DigrandeArduino/ArduinoAeroglisseur/rapportFinSeances/digrandeThomas/rapportSeance09-12-19.md

Tâche réalisé par Thomas Di Grande
Rapport Seance 01

Travail maison avant séance : Réalisation des plans 3d de la structure de la jupe; Réalisation du planning et de la répartition des tâches première séances; Commande matérielle (moteurs, contrôleurs, câbleries).

Voici l'ensemble des tâches réalisé durant cette première séance : téléchargement d'un logiciel de création du fichier SVG; Preparation du plan 3d des deux pièces de la jupe pour la découpe laser; Pour ce faire, utilisation du logiciel Inkscape. But : créé une image vectorielle du plan 2D; Plan vectoriel au format SVG; Envoie de ce fichier au FabLab pour découpe laser des deux pièces.

Final : rendez vous avec le FabLab pour realisé la decoupe laser des deux pieces.

Suite de la séance : Test des moteurs brushless avec un code d'essai (voir dossier code; fichier testbrushless.md). Résultat : puissance motrice suffisante pour générer un flux d'air important. Flux d'air suffisant (?) : à confirmer. Suite : Trouver deux hélices de tailles  120 mm. Commande des hélices.

Matériel obtenue à ce jour : 6 controleurs brushless; moteurs brushless; Cablerie; Alimentation de test.
                             
Modification de la structure sur le plan 3D pour fixer les moteurs surs la chassie de la jupe.
Mail envoyé au FabLab.

Fin de rapport;
