DigrandeArduino/ArduinoAeroglisseur/cahierDesCharge.md

Cahier des charge du projet arduino :
|------------------------------------------------------------------------------------------
| Informations générales :
|------------------------------------------------------------------------------------------
| Noms : Arduino Aerogliseur; ArduinoGlisseur;
| Entreprise : Aero Tech Industrie;
| Type : Véhicule terrestre;
| Nom responsable projet : P. Masson;
| Noms participants projet : Thomas Di Grande -- Julien Whitfield;
|------------------------------------------------------------------------------------------
| Contraintes : (A -> Prioritaire; B -> option)
|------------------------------------------------------------------------------------------
| A-1 : Le prototype doit pouvoir se soulever au-dessus du sol;
| A-2 : Le prototype doit être autonome en energie pour une durer supèrieurs à 10 minutes;
| A-3 : Le prototype doit avoir une solidité suffisante pour résister à des chocs légers voire modérer;
| A-4 : Le prototype doit être stable peut importe la surface;
| A-5 : Le prototype doit être soulevé au dessus du sol par deux moteurs type brushless;
| A-6 : Le prototype doit être auto propulsé par deux moteurs arrières;
| A-7 : Le prototype doit resté stable lors de ses déplacements;
| A-8 : Le prototype doit être radio guidé par l'utilisateur; 
| -8- : La conception inclut la réalisation de la télécommande RF;
| A-9 : Le prototype doit être facilement réparable; 
| -9- : Accès simplifié au câble et cartes électroniques;
|------------------------------------------------------------------------------------------
| B-1 : Le prototype doit pouvoir renvoyer une vidéo en direct à l'utilisateur;
| -1- : Retour video sur ordinateur ou smartphone par liaison WIFI;
| B-2 : Le prototype doit être esthétique;
| -2- : Ajout d'une maquette de cabine + autocollant + peinture;
| B-3 : Le prototype doit détecter les obstacles, gestion arrêt d'urgence;
| B-4 : Le prototype doit être équipé d'un canon antiaérien;
| -4- : En réponse à un projet concurrent, dans l’éventualité qu'il fonctionne (le projet concurrent);
| B-5 : Detaillage de la décoration si temps disponible;
|------------------------------------------------------------------------------------------
| Contrainte suplémentaire : Le prototype ne doit pas exploser ou s'enflammer spontanément.
|------------------------------------------------------------------------------------------
