DigrandeArduino/ArduinoAeroglisseur/rapportFinSeances/digrandeThomas/rapportSeance19.02.2020.pdf

## Rapport Séance n°7 20.02.2020

Thomas Di Grande Peip 2 G1

Travaux réalisés avant la séance :

- Démontage total de toute l’électroniques
- Test de chaque moteur séparer sur banc d’essai.
- Test de chaque contrôleur séparer sur banc d’essai.
- Démontage de la structure central de support des cartes électroniques.

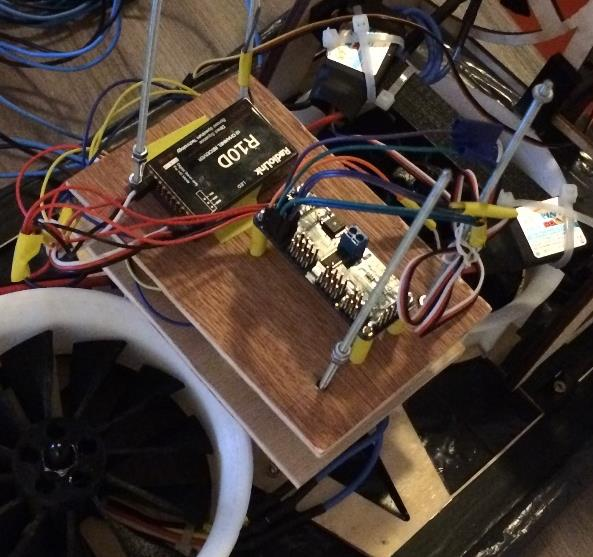
[picture p17: figure]

<- Cette pièce là

- Bilan des tests :
➔ Tous les moteurs fonctionnent.
➔ Tous les contrôleurs fonctionnent.
➔ L’ensemble carte + générateur PWM fonctionne.

Les dégâts causés par la coupure de courant à la suite d’un court-circuit dans l’alimentation sont mineur et n’ont engendré aucun dommage sur le matériel.

- Remontage de toutes l’électronique : soudage de tous les câbles avec sécurisation des soudures par gaine thermo-rétractable.
- Bilan de la reconstruction : 6h de travail samedi mais le prototype fonctionne
- Problème constater : erreur au niveau du code, sera corriger durant la séance.

Travaux réalisés durant la séance :

- Correction des erreurs dans le code :
➔ Calibrage des hélices
➔ Synchronisation entre les paliers de démarrage des moteurs et les joysticks de la télécommande.
- Récupération du matériel demander : sac renforcer plastique pour la nouvelle jupe de l’aéroglisseur.
- Etat du prototype après réparation :

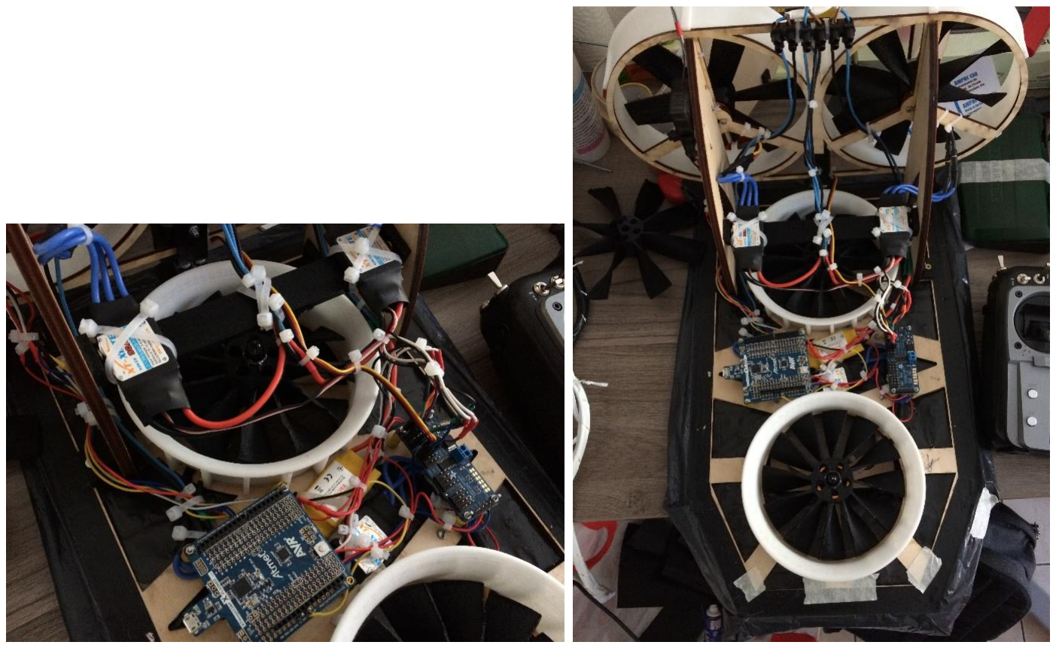
[picture p18: figure]

- Premier test de déplacement :
➔ Le prototype fonctionne, est capable de se soulever, d’avancer et de tourner.
➔ Problème constater : difficulté à tourner, pourras être partiellement corriger par le changement des hélices de propulsion.
➔ Autre problème : obligation de placer une roue folle à l’arrière du prototype. Pourras être corriger en améliorant les hélices de sustentation et en réajustant le poids à l’arrière.
- Bilan globale :
Premiers tests de déplacement concluent. Le prototype fonctionne correctement, est suffisamment solide pour résister à des chocs légers contre les murs (non le pilote n’est pas incompétent bien au contraire, c’est le prototype qui est légèrement incontrôlable…).

- Les changements de direction sont globalement faisables.
- Les objectifs suivants sont surtout de réoptimiser et de stabiliser le prototype.

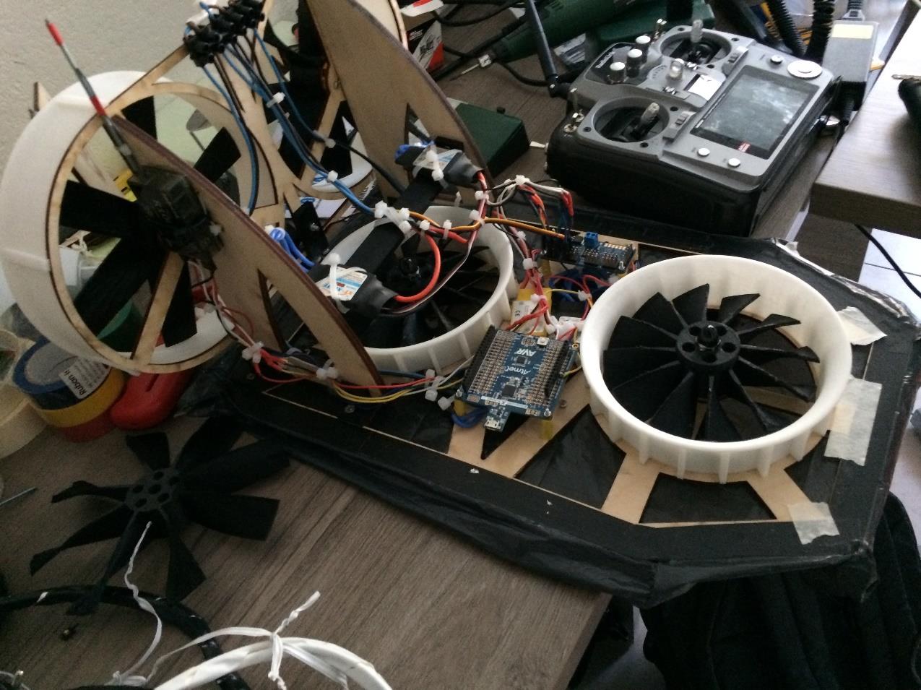
[picture p19: figure]

Fin de rapport ;
