DigrandeArduino/ArduinoAeroglisseur/rapportFinSeances/whitfieldJulien/rapportSeance06-02-2020.pdf

Taches effectuées par WHITFIELD Julien Rapport séance 05

- Compréhension du générateurPWM
- Intégration de la parties PWM au code et au branchement
- Réglage de la puissance des moteurs
- Test de tous les moteurs en même temps
- Programmation d’un bouton on/off
- Fin du code pour la télécommande
