DigrandeArduino/ArduinoAeroglisseur/rapportFinSeances/whitfieldJulien/rapportSeance13-01-2020.pdf

Taches effectuées par WHITFIELD Julien Rapport séance 04

Travaille effectuée :

- Fin du code pour la télécommande
- tests du code sur tous les moteurs, réussite
- test de la télécommande sur les moteurs sur l’aéroglisseur
- obtention d’un générateur PWM pour pouvoir contrôler tous moteurs en même temps

Suite de la séance :

- Apprendre a utiliser et brancher le générateur PWM
- Test de tout moteurs en même temps

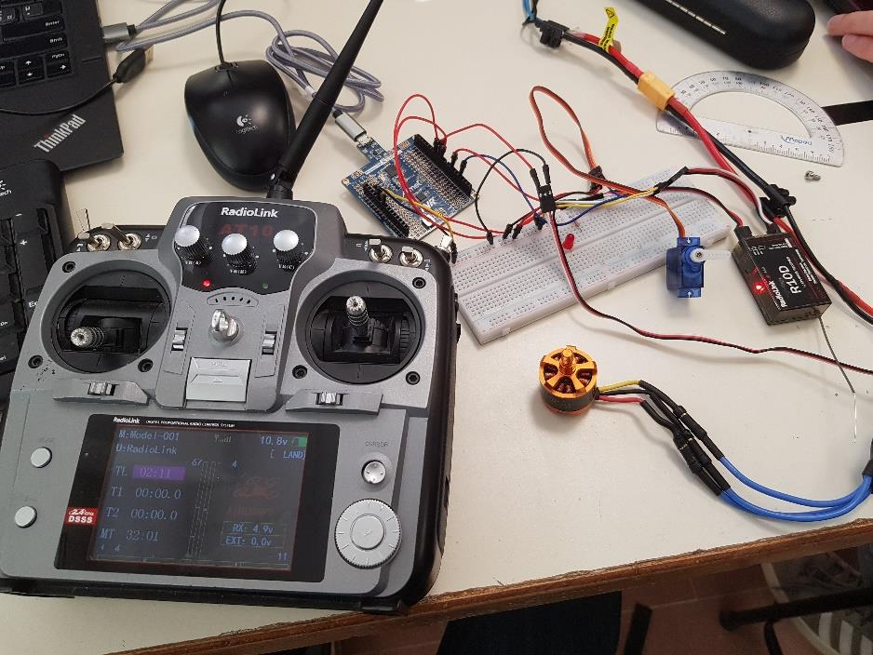
[picture p35: figure]

Télécommande avec moteur brushless et servomoteur connecte a la carte Arduino

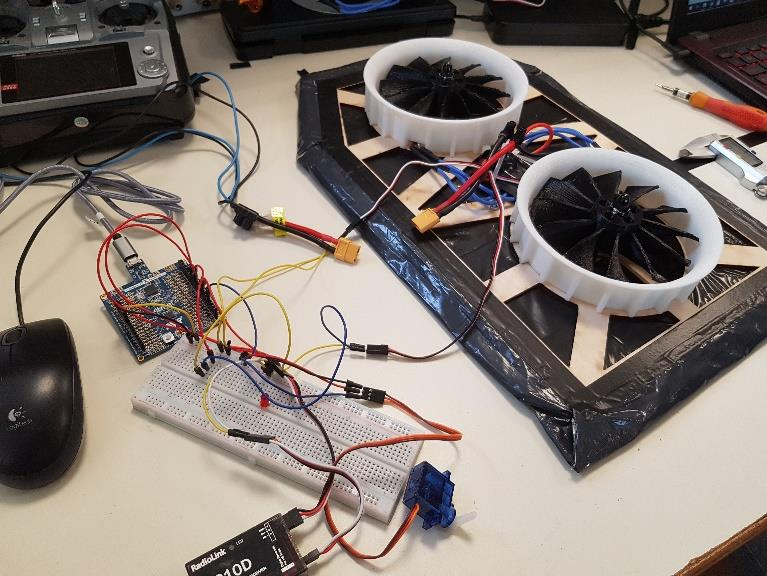
[picture p36: figure]

Moteurs brushless de l’aéroglisseur connecte a la télécommande
