DigrandeArduino/ArduinoAeroglisseur/rapportFinSeances/digrandeThomas/rapportSeance16-12-19.md.pdf

## Rapport Séance n°2 16.12.2019

Thomas Di Grande Peip 2 G 1

Travaux réalisés avant la séance :

- Finalisation de la modélisation 3D de la structure de la jupe.
- Création du modèle de découpe 2D laser. Type de fichier en .svg destiné pour la découpeuse CNC laser.
- Vendredi 13.12.2019 : réalisation de la découpe laser au FabLab de l’école :

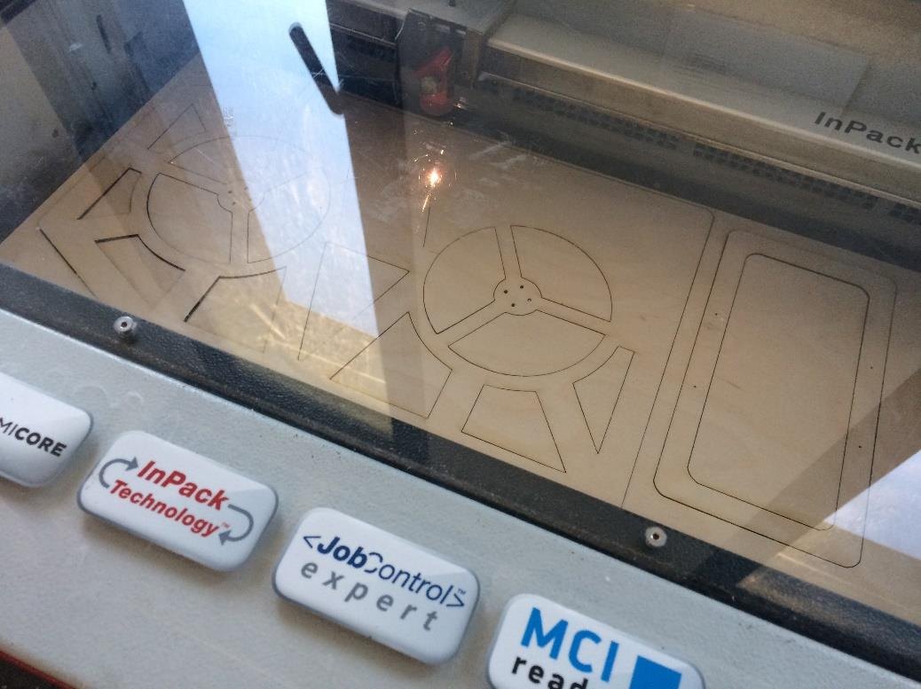
[picture p44: figure]

- Résultat final satisfaisant après découpe :

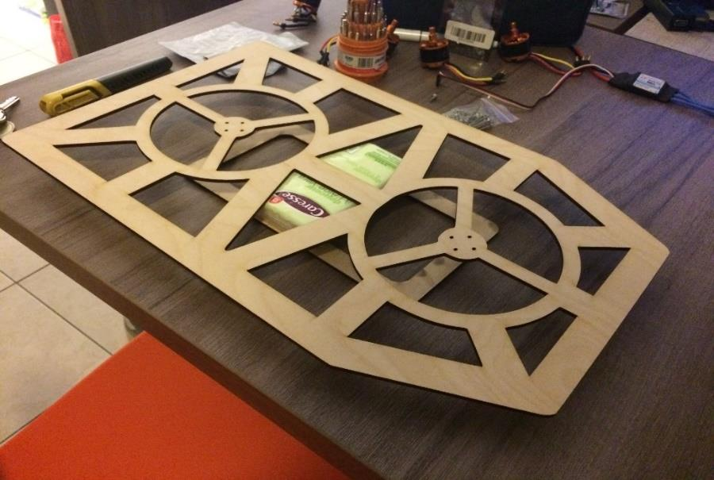
[picture p45: figure]

- Vidéo de la découpe laser : https://www.youtube.com/watch?v=YqbRCXbXSbshttps://www.youtube.com/watch?v=GnK8k1fjNbw

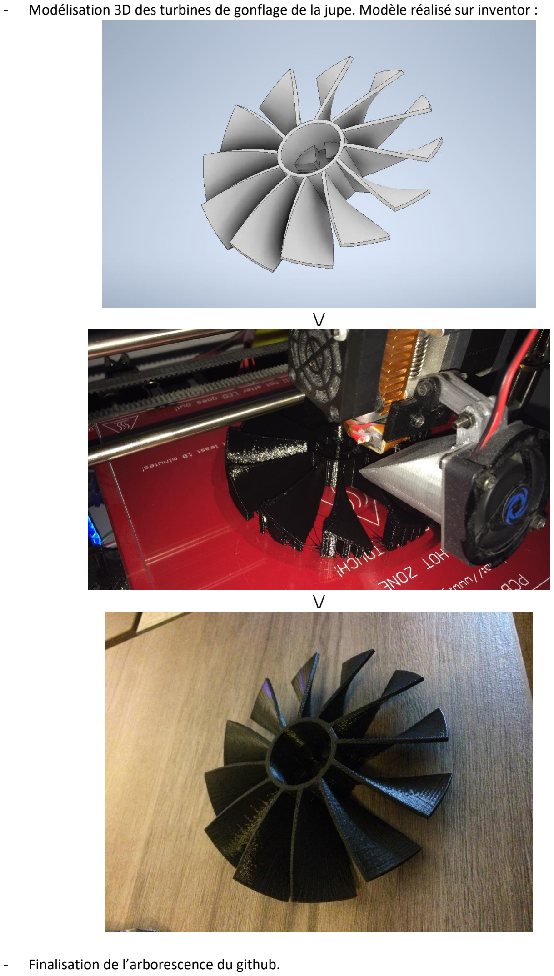
[picture p46: page 2]

- Modélisation 3D des turbines de gonflage de la jupe. Modèle réalisé sur inventor :

\/

\/

- Finalisation de l’arborescence du github.

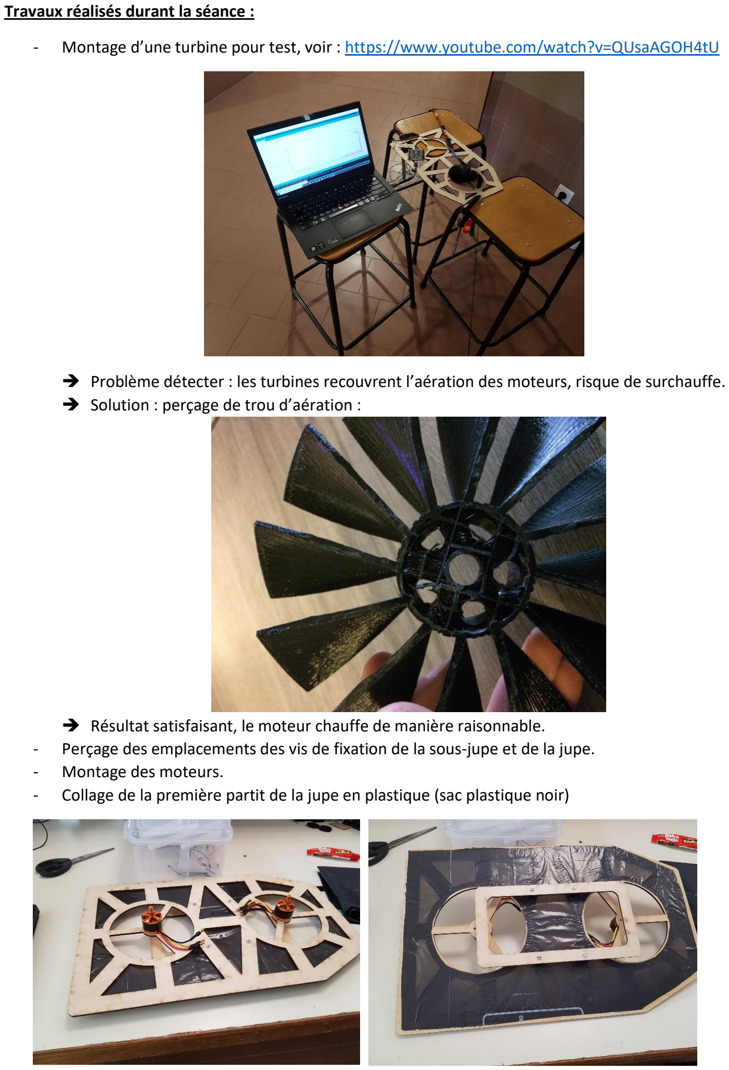
[picture p47: page 3]

Travaux réalisés durant la séance :

- Montage d’une turbine pour test, voir : https://www.youtube.com/watch?v=QUsaAGOH4tU

➔ Problème détecter : les turbines recouvrent l’aération des moteurs, risque de surchauffe. ➔ Solution : perçage de trou d’aération :

➔ Résultat satisfaisant, le moteur chauffe de manière raisonnable.
- Perçage des emplacements des vis de fixation de la sous-jupe et de la jupe.
- Montage des moteurs.
- Collage de la première partit de la jupe en plastique (sac plastique noir)

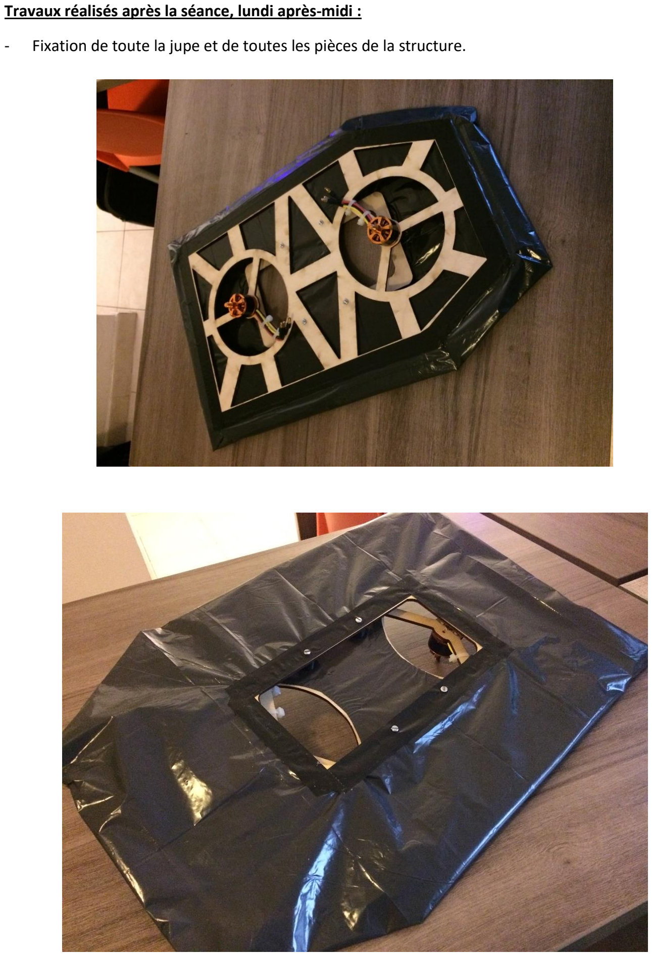
[picture p48: page 4]

Travaux réalisés après la séance, lundi après-midi :

- Fixation de toute la jupe et de toutes les pièces de la structure.

- Etat final du projet à ce jour : jupe terminé, structure de base terminé, motorisation terminée, premier test en attente (raison : 2 pièces 3D à refaire et 1 écrou spécial drone manquant). Les pièces manquantes seront récupérées dans un magasin de modélisme.

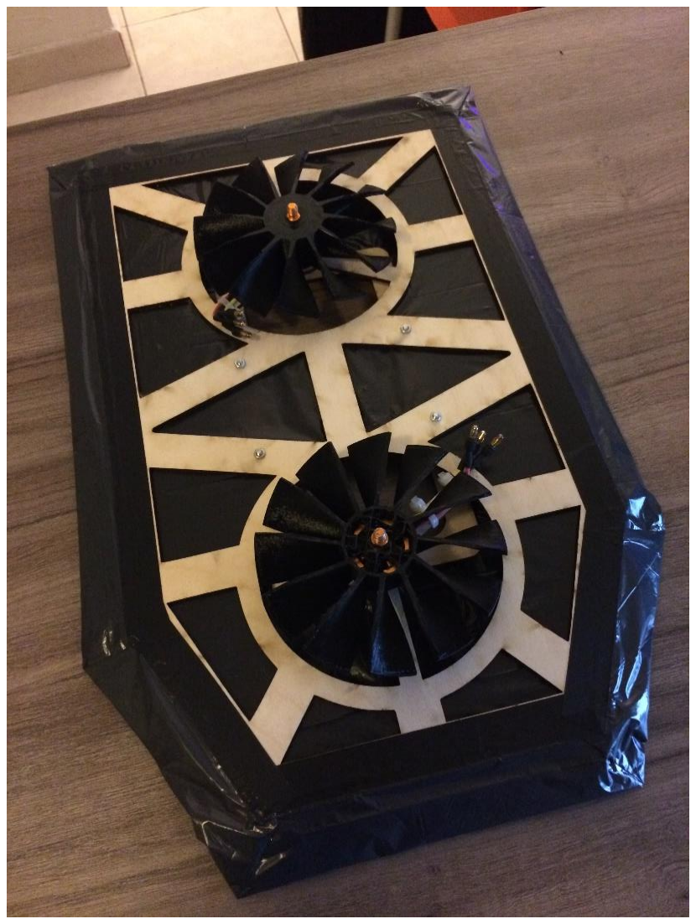
[picture p49: figure]

Fin de rapport.
