DigrandeArduino/ArduinoAeroglisseur/rapportFinSeances/whitfieldJulien/rapportSeance09-12-19.md

Taches effectuées par Julien WHITFIELD
Rapport Séance 01 

Travaille avant la séance :
-Réalisation du planning et de la répartition des tâches
-Réalisation des croquis du plan 2D

Travaille effectuer :
-Démontage du drone pour récupérer les moteurs brushless pour le projet.
-Apprendre comment marche les moteur brushless
-Trouver et brancher les ports du moteur à l'alimentation et à la carte Arduino
-Test avec succès du moteur brushless
-recherche d’une hélice compatible avec le plan de l’aéroglisseur

Suite de la séance :
-Construire la base de l’aéroglisseur 
-fabriquer la jupe
-tester l’équilibre avec les hélices
