DigrandeArduino/ArduinoAeroglisseur/planAeroglisseur/info.md

Ici sont placés les plans du projet

Here are placed all projects plans
