DigrandeArduino/ArduinoAeroglisseur/rapportFinSeances/whitfieldJulien/rapportSeance17-12-19.md.pdf

Taches effectuées par Julien WHITFIELD Rapport Séance 01

Travaille effectuer :

-accrochage d’un moteur a la base de l’aéroglisseur

-1

er test pour voir si les moteurs marchent

-gérer le problème lié à l’hélice

-test du moteur pour avoir la puissance et le chauffage du moteur

-test avec des trous d’aération avec succès

-découpage d’un sac poubelle pour faire la jupe

-montage du support sous jupe

Suite de la séance :

-tester les deux moteurs

-mettre la jupe

-test de l’sustentation de l’aéroglisseur

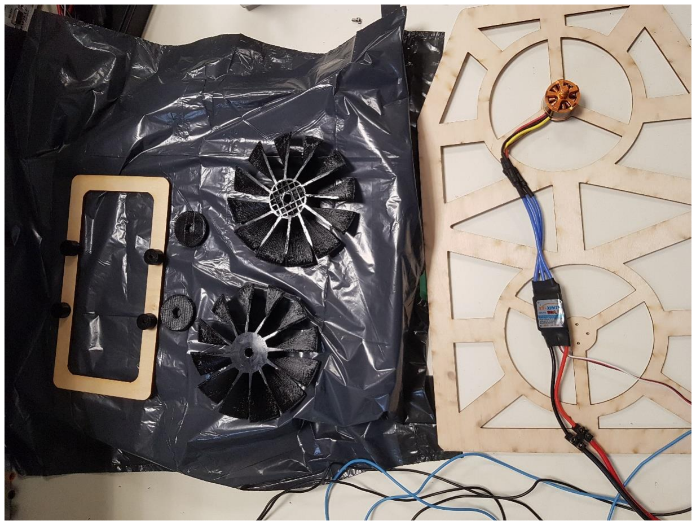
[picture p54: figure]

Matériel a disposition

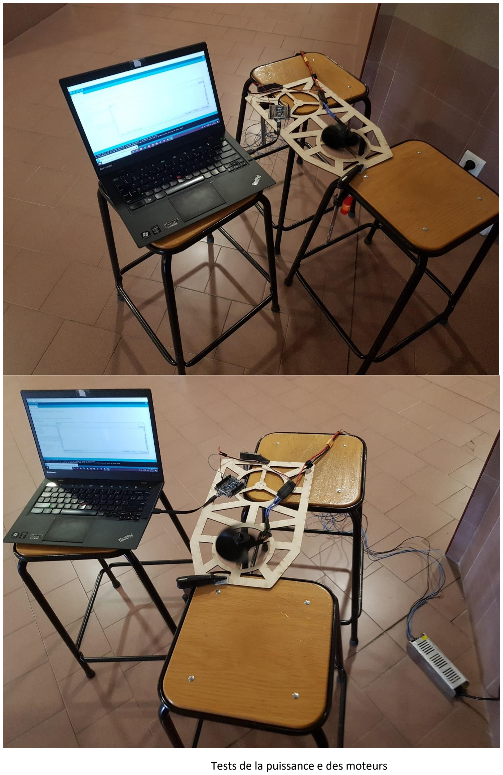
[picture p55: page 2]

Tests de la puissance e des moteurs
