DigrandeArduino/ArduinoAeroglisseur/planAeroglisseur/fichier3D_stl/gouverne.stl

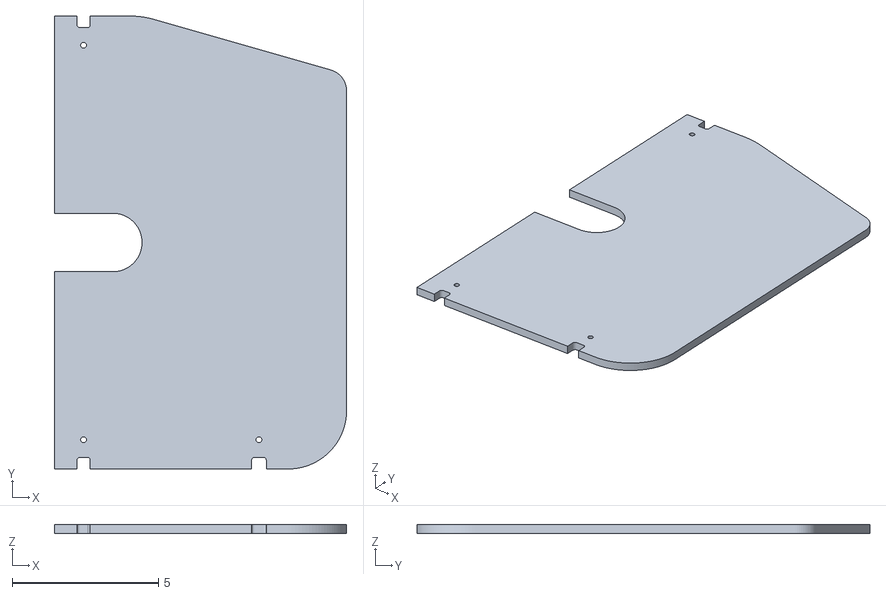
[picture p56: CAD file, 2020-01-15]
planAeroglisseur/fichier3D_stl/gouverne.stl
10.0 x 15.5 x 0.3
