DigrandeArduino/ArduinoAeroglisseur/planAeroglisseur/fichier3D_stl/supportArrière.stl

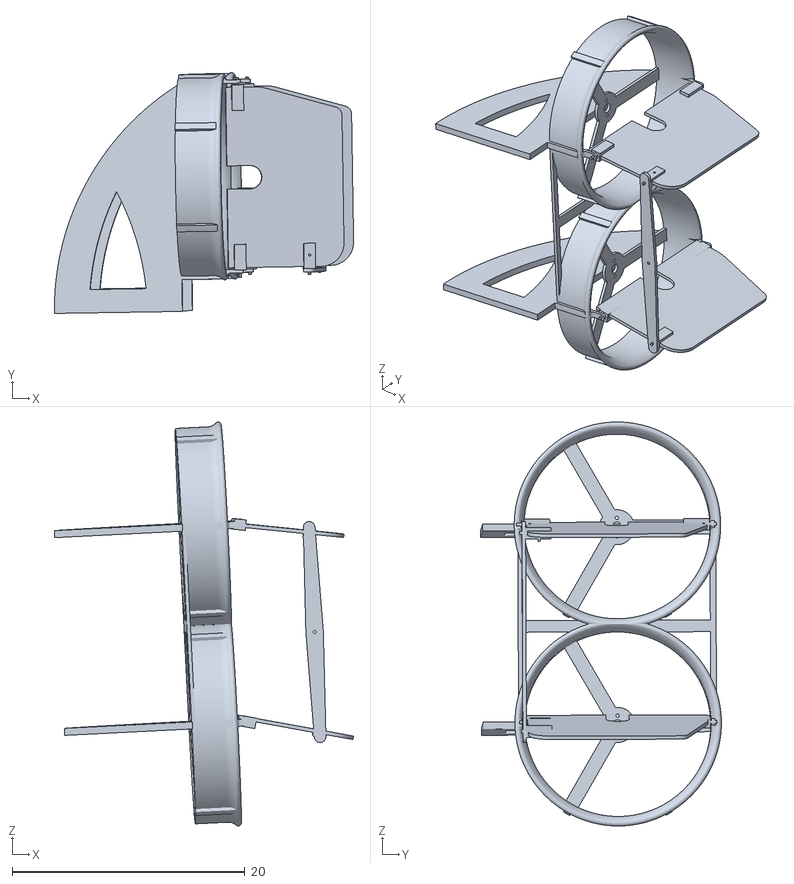
[picture p57: CAD file, 2020-01-15]
planAeroglisseur/fichier3D_stl/supportArrière.stl
25.7 x 20.7 x 34.7
