DigrandeArduino/ArduinoAeroglisseur/planAeroglisseur/fichier3D_stl/supportGouverne.stl

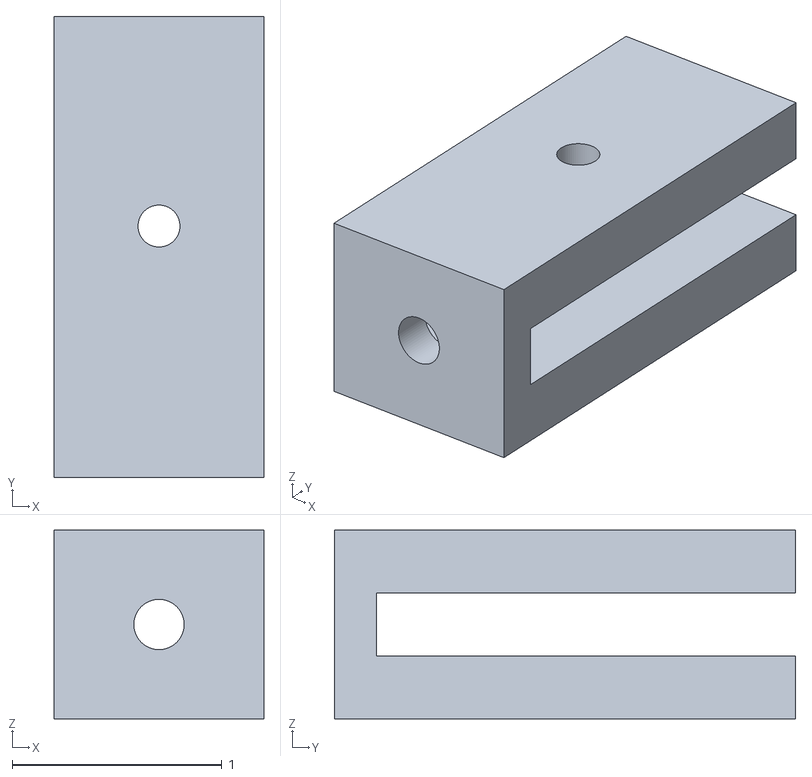
[picture p58: CAD file, 2020-01-15]
planAeroglisseur/fichier3D_stl/supportGouverne.stl
1.00 x 2.20 x 0.9
