DigrandeArduino/ArduinoAeroglisseur/planAeroglisseur/fichier3D_stl/supportChâssis.stl

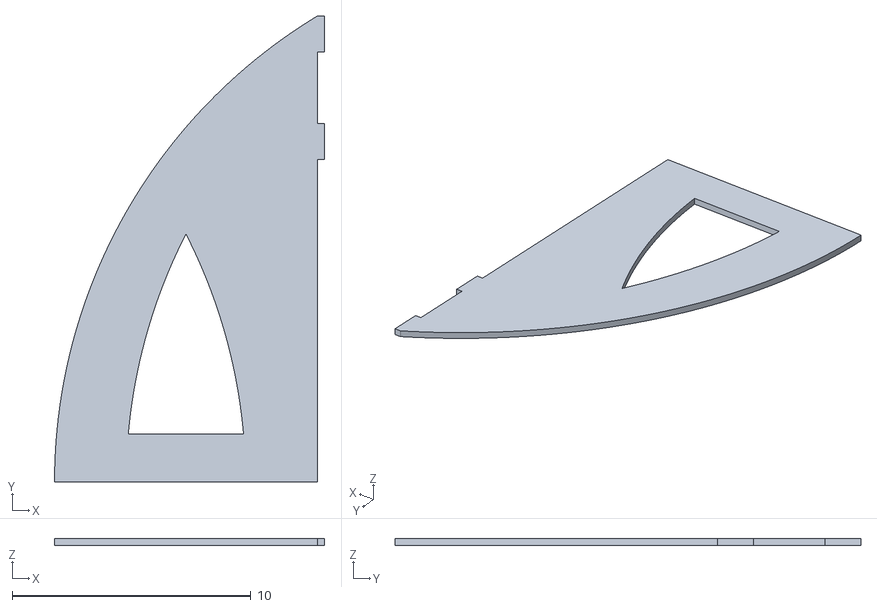
[picture p59: CAD file, 2020-01-15]
planAeroglisseur/fichier3D_stl/supportChâssis.stl
11.3 x 19.5 x 0.3
