DigrandeArduino/ArduinoAeroglisseur/planAeroglisseur/fichier3D_stl/supportMoteurs.stl

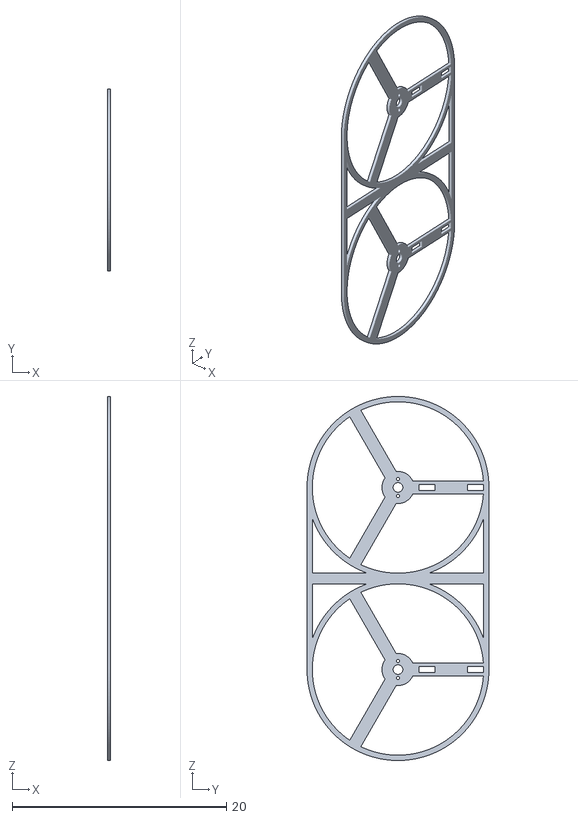
[picture p60: CAD file, 2020-01-15]
planAeroglisseur/fichier3D_stl/supportMoteurs.stl
0.3 x 17.0 x 34.0
