DigrandeArduino/ArduinoAeroglisseur/planAeroglisseur/fichier3D_stl/bielle.stl

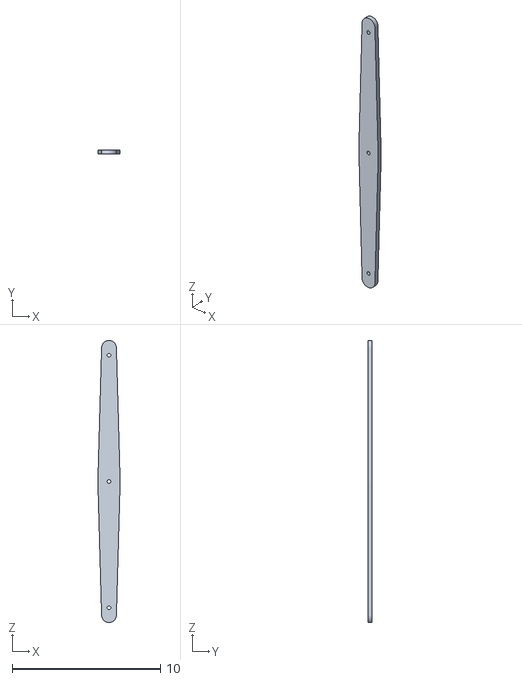
[picture p61: CAD file, 2020-01-15]
planAeroglisseur/fichier3D_stl/bielle.stl
1.50 x 0.3 x 19.0
