DigrandeArduino/ArduinoAeroglisseur/planAeroglisseur/fichier3D_stl/hélicePropulsion.stl

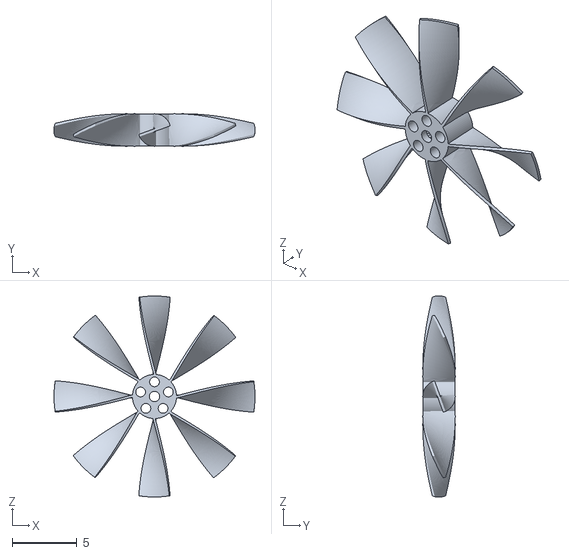
[picture p62: CAD file, 2020-01-15]
planAeroglisseur/fichier3D_stl/hélicePropulsion.stl
15.5 x 2.51 x 15.5
