DigrandeArduino/ArduinoAeroglisseur/planAeroglisseur/fichier3D_stl/guideAir.stl

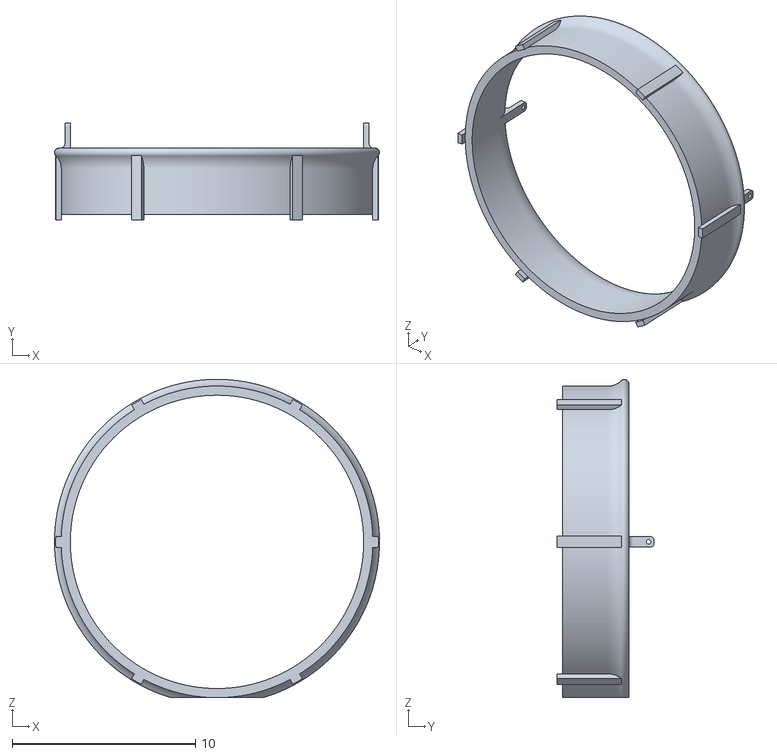
[picture p63: CAD file, 2020-01-15]
planAeroglisseur/fichier3D_stl/guideAir.stl
17.7 x 5.30 x 17.4
