DigrandeArduino/ArduinoAeroglisseur/planAeroglisseur/fichier3D_stl/SupporSousJupe.stl

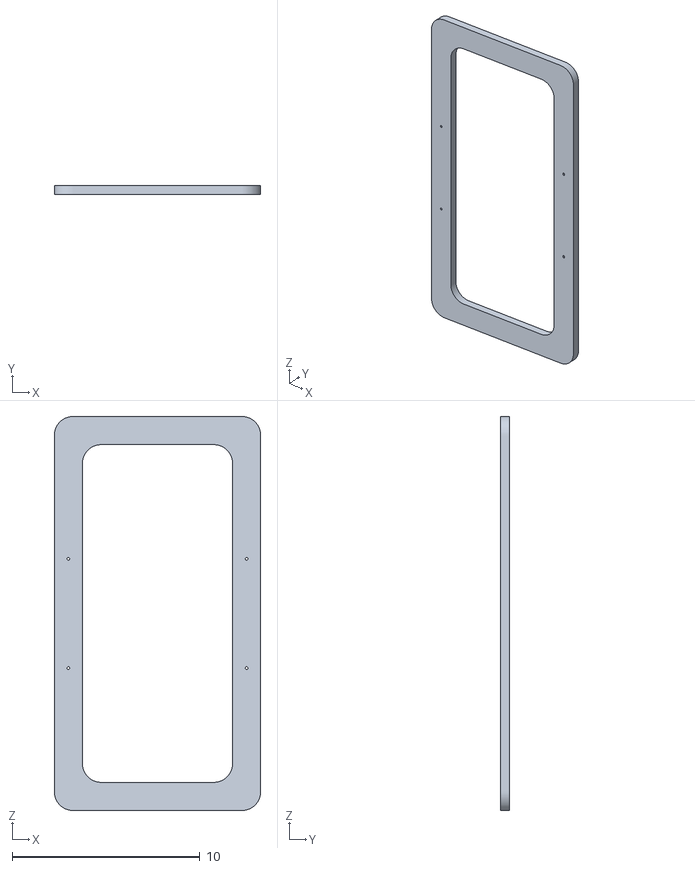
[picture p64: CAD file, 2019-12-17]
planAeroglisseur/fichier3D_stl/SupporSousJupe.stl
11.0 x 0.5 x 21.0
