DigrandeArduino/ArduinoAeroglisseur/planAeroglisseur/fichier3D_stl/JupeAeroglisseur.stl

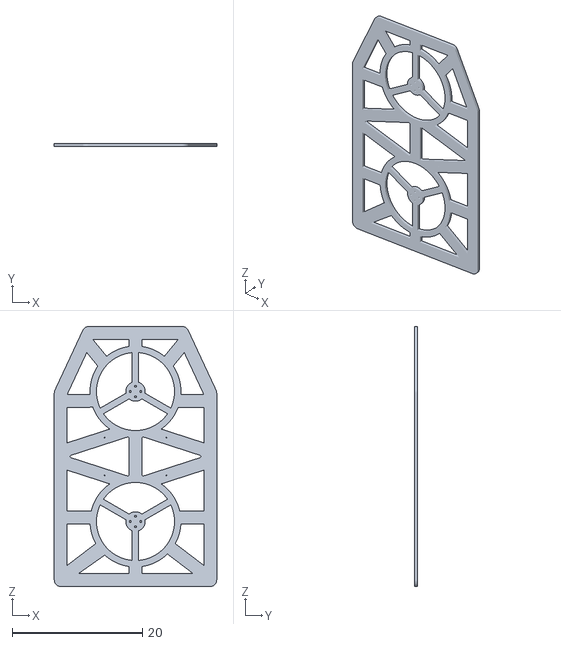
[picture p65: CAD file, 2019-12-17]
planAeroglisseur/fichier3D_stl/JupeAeroglisseur.stl
25.0 x 0.5 x 40.0
