DigrandeArduino/ArduinoAeroglisseur/planAeroglisseur/fichier3D_stl/Base.stl

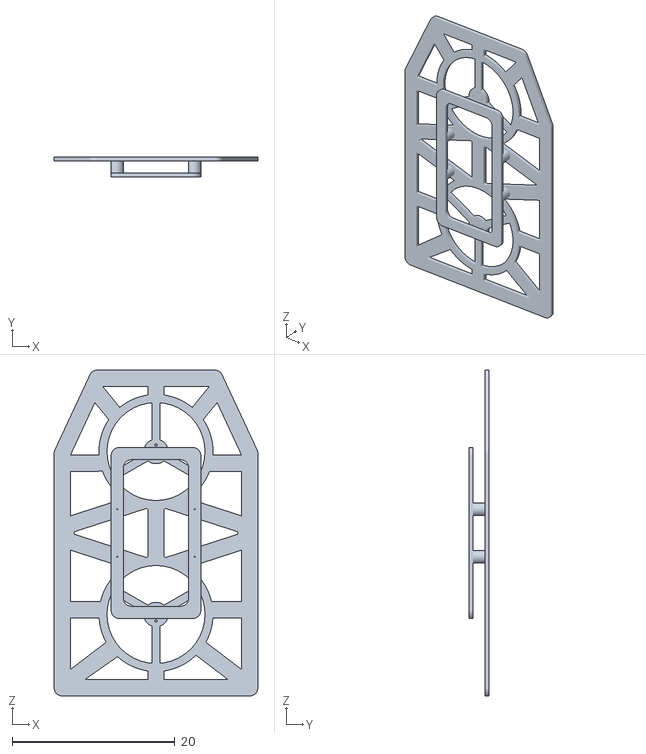
[picture p66: CAD file, 2019-12-17]
planAeroglisseur/fichier3D_stl/Base.stl
25.0 x 2.50 x 40.0
