DigrandeArduino/ArduinoAeroglisseur/planAeroglisseur/fichier3D_stl/AeroglisseurProto1.stl

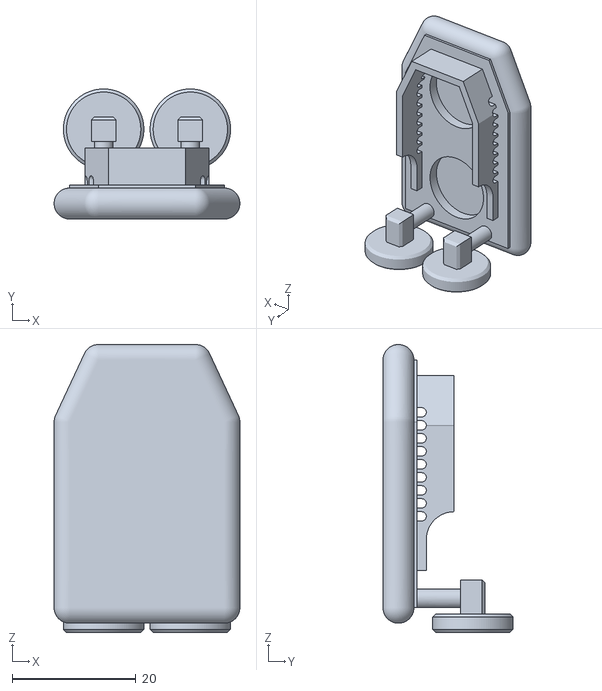
[picture p67: CAD file, 2019-12-17]
planAeroglisseur/fichier3D_stl/AeroglisseurProto1.stl
30.0 x 21.0 x 46.5
