DigrandeArduino/ArduinoAeroglisseur/planAeroglisseur/fichier3D_stl/turbine.stl

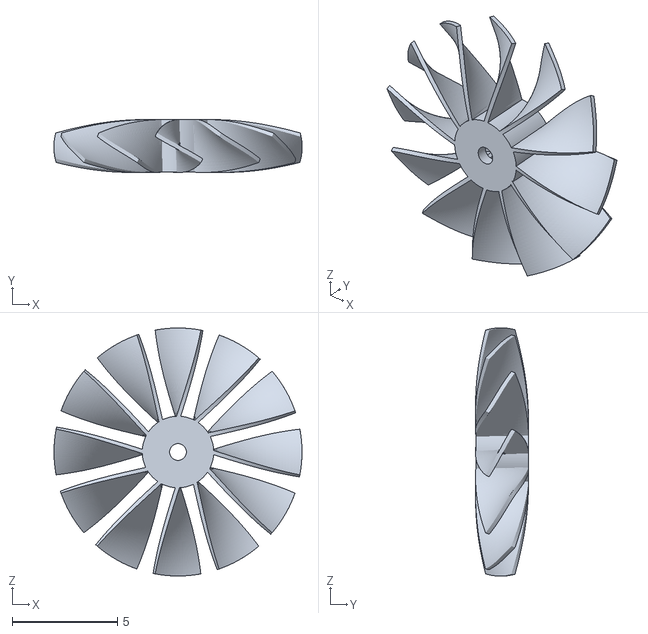
[picture p68: CAD file, 2019-12-17]
planAeroglisseur/fichier3D_stl/turbine.stl
11.8 x 2.52 x 11.8
