DigrandeArduino/ArduinoAeroglisseur/planAeroglisseur/GuideAir.pdf

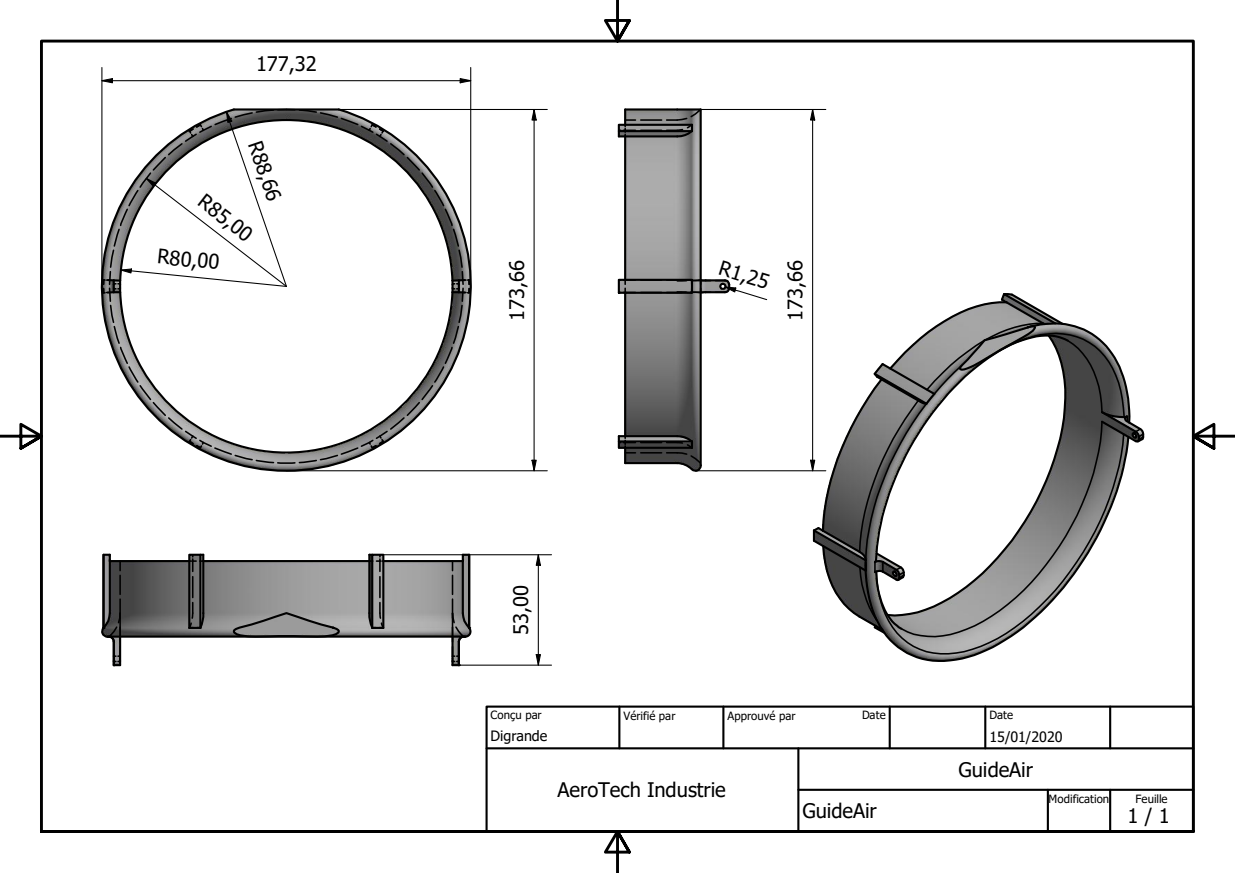
[picture p69: page 1]

Conou par Digrande | Vprifip par | Approuvp par Date | Date 15/01/2020

AeroTech Industrie | GuideAir

GuideAir | Modification | Feuille 1 / 1
