DigrandeArduino/ArduinoAeroglisseur/planAeroglisseur/gouverne.pdf

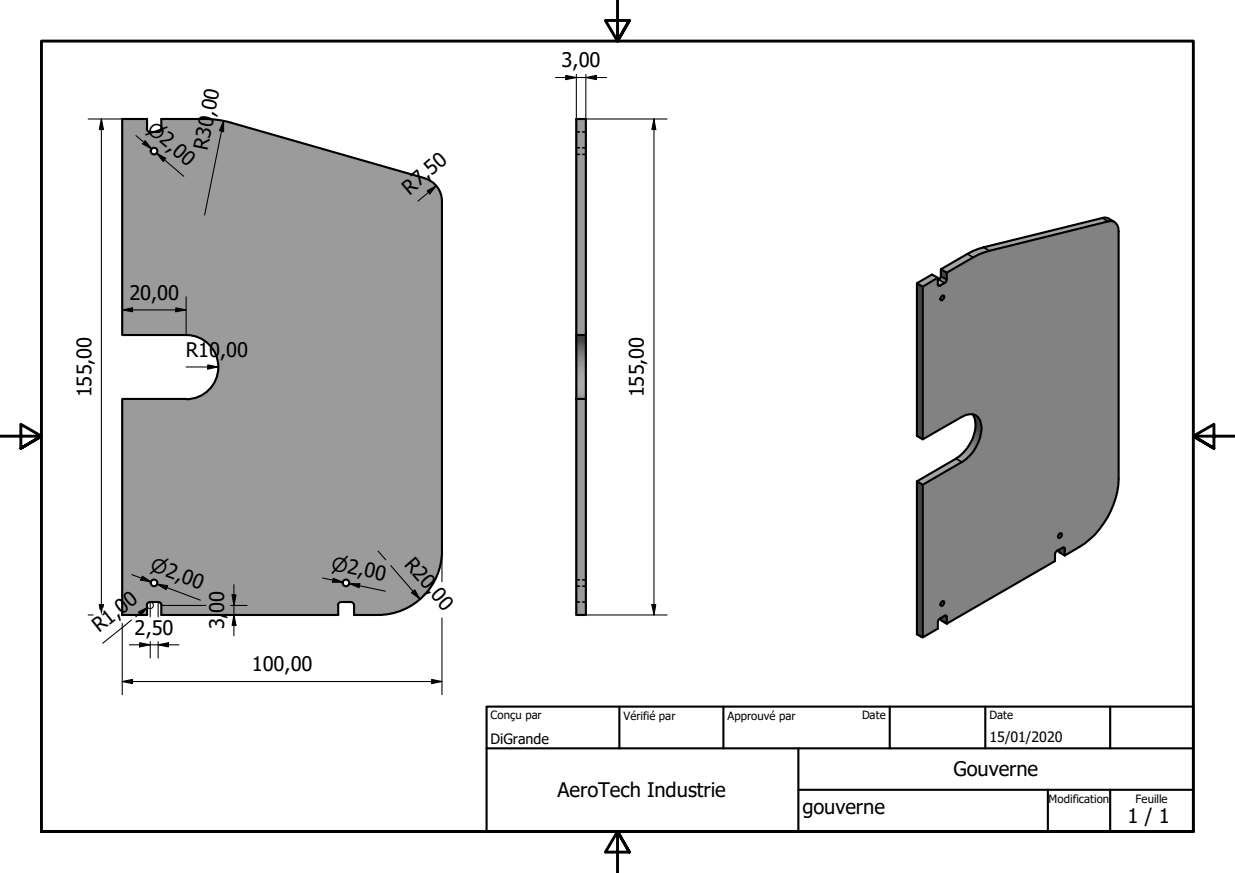
[picture p70: page 1]

Conou par DiGrande | Vprifip par | Approuvp par Date | Date 15/01/2020

AeroTech Industrie | Gouverne

gouverne | Modification | Feuille 1 / 1
