DigrandeArduino/ArduinoAeroglisseur/planAeroglisseur/bielle.pdf

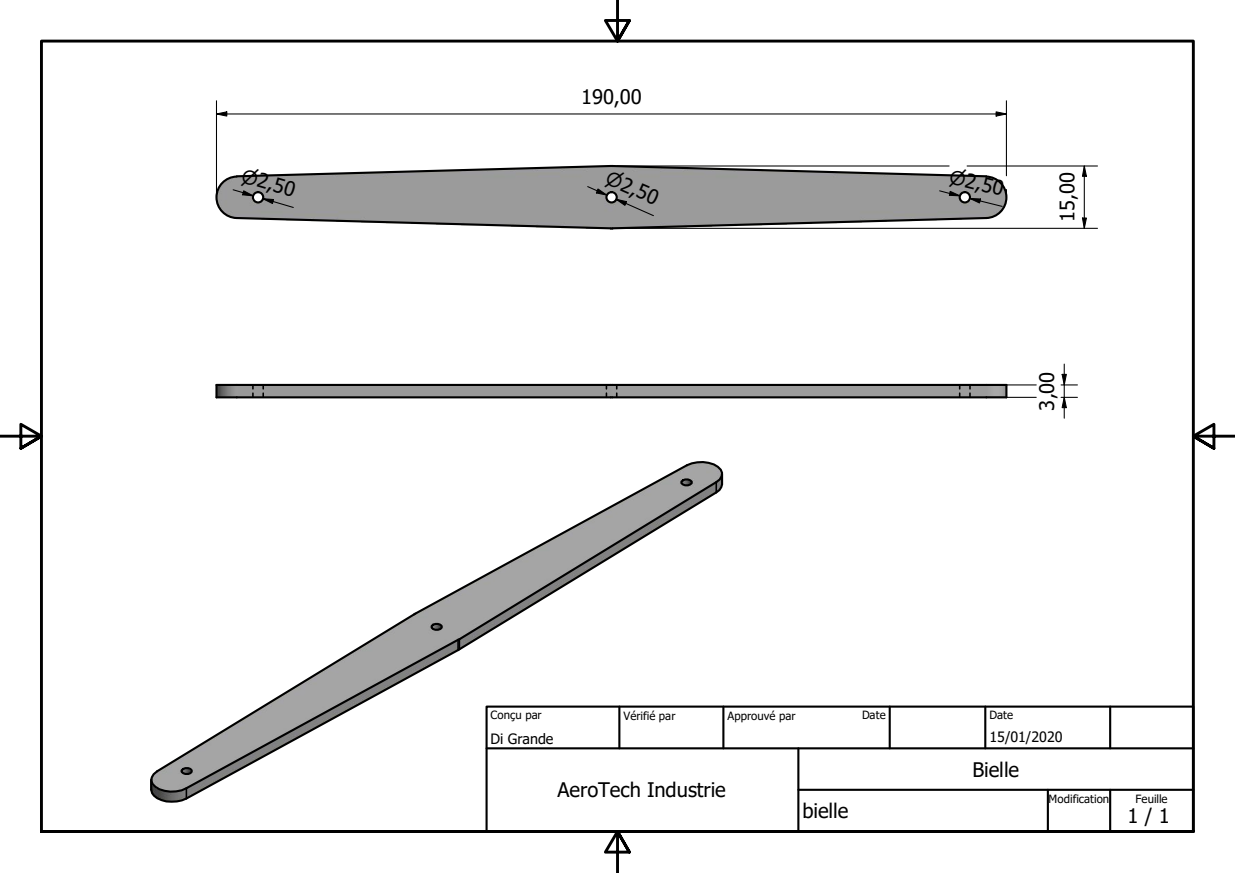
[picture p71: page 1]

Conou par Di Grande | Vprifip par | Approuvp par Date | Date 15/01/2020

AeroTech Industrie | Bielle

bielle | Modification | Feuille 1 / 1
