DigrandeArduino/ArduinoAeroglisseur/planAeroglisseur/helicePropultion.pdf

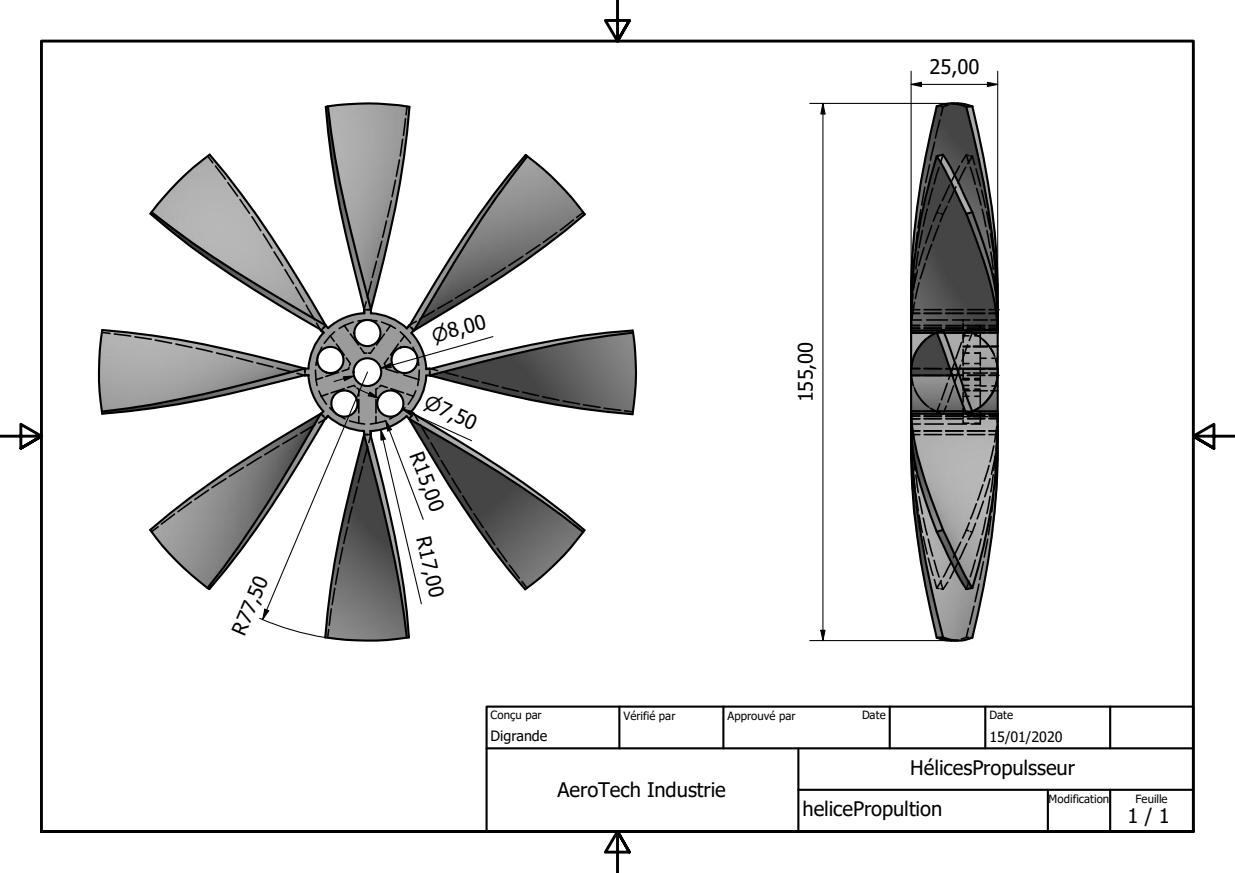
[picture p72: page 1]

Conou par Digrande | Vprifip par | Approuvp par Date | Date 15/01/2020

AeroTech Industrie | HplicesPropulsseur

helicePropultion | Modification | Feuille 1 / 1
