DigrandeArduino/ArduinoAeroglisseur/planAeroglisseur/supportChâssis.pdf

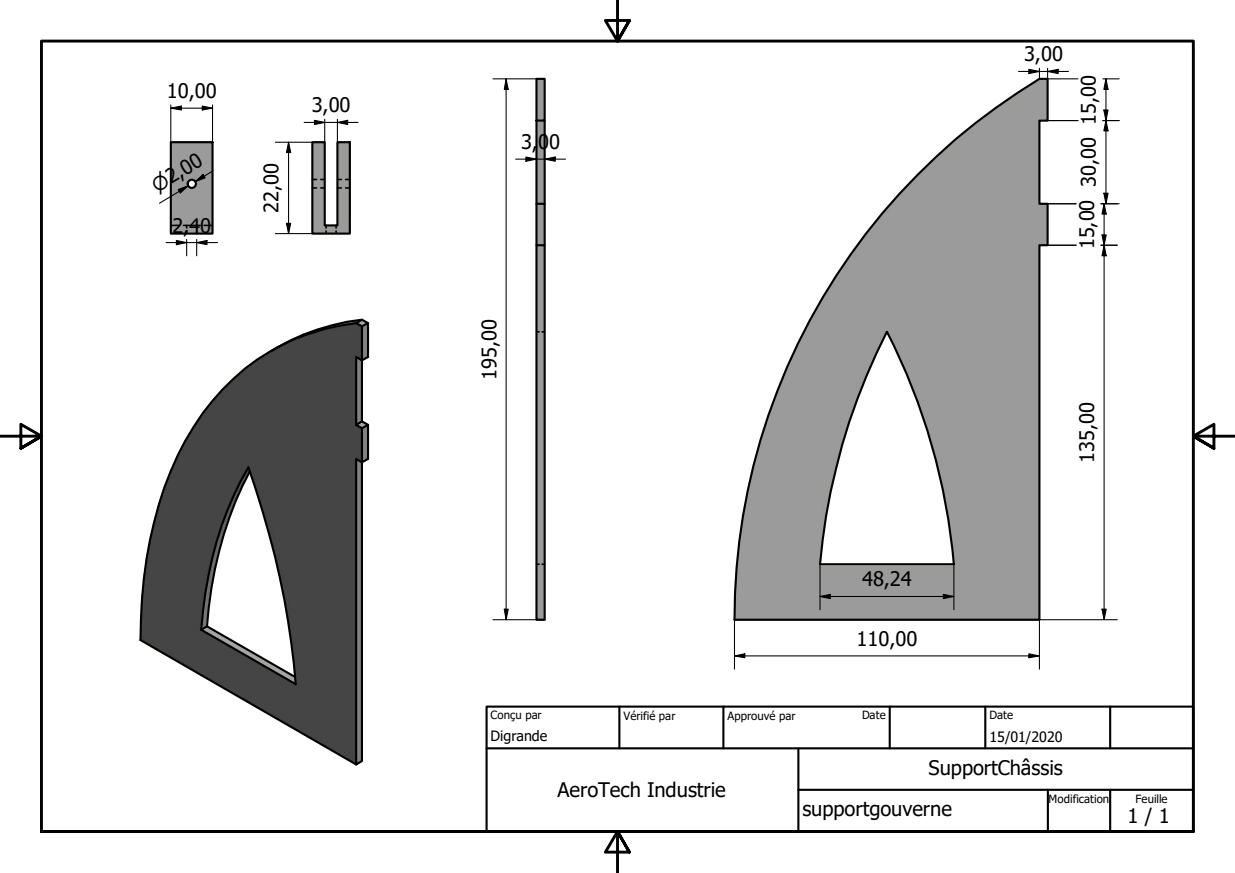
[picture p73: page 1]

Conou par Digrande | Vprifip par | Approuvp par Date | Date 15/01/2020

AeroTech Industrie | SupportChkssis

supportgouverne | Modification | Feuille 1 / 1
