DigrandeArduino/ArduinoAeroglisseur/planAeroglisseur/supportMoteurs.pdf

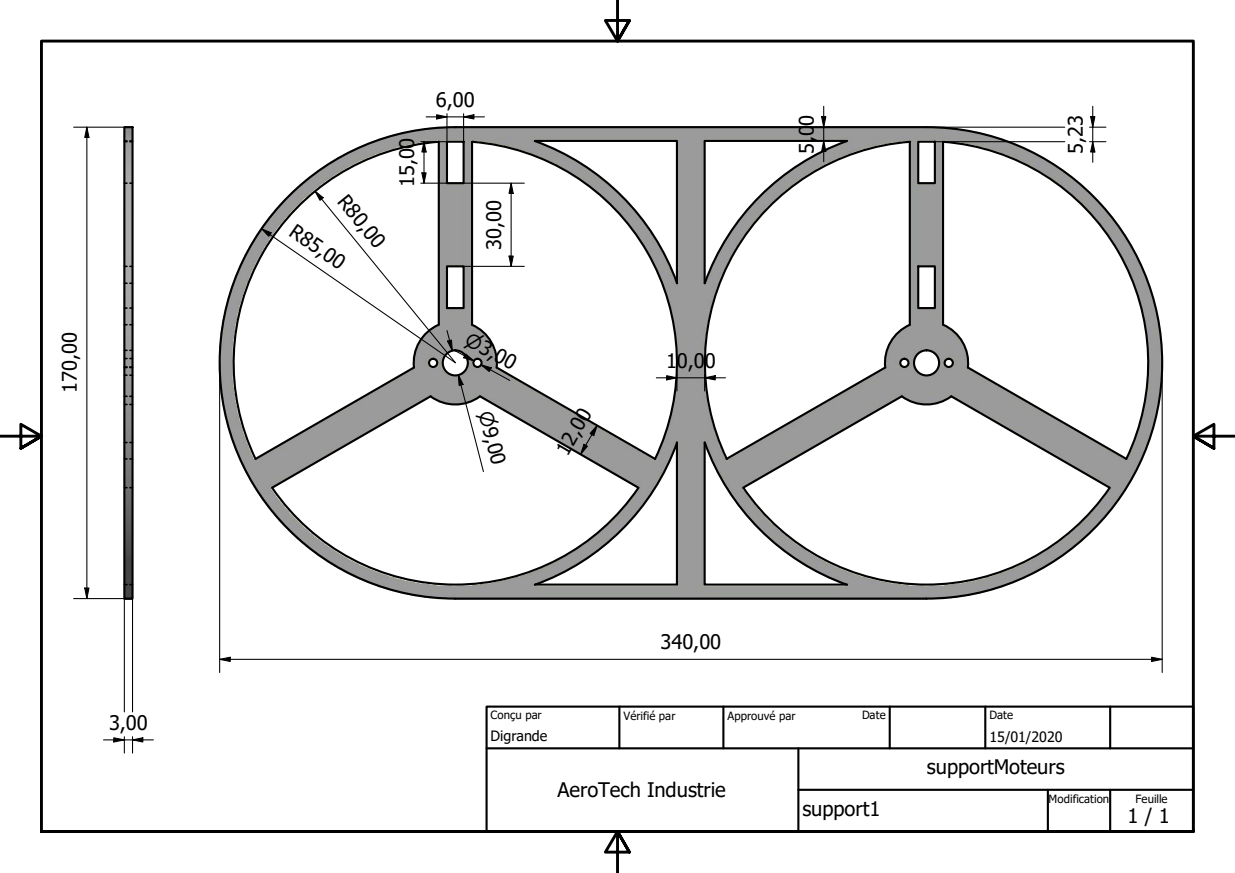
[picture p74: page 1]

Conou par Digrande | Vprifip par | Approuvp par Date | Date 15/01/2020

AeroTech Industrie | supportMoteurs

support1 | Modification | Feuille 1 / 1
