DigrandeArduino/ArduinoAeroglisseur/planAeroglisseur/Turbine.pdf

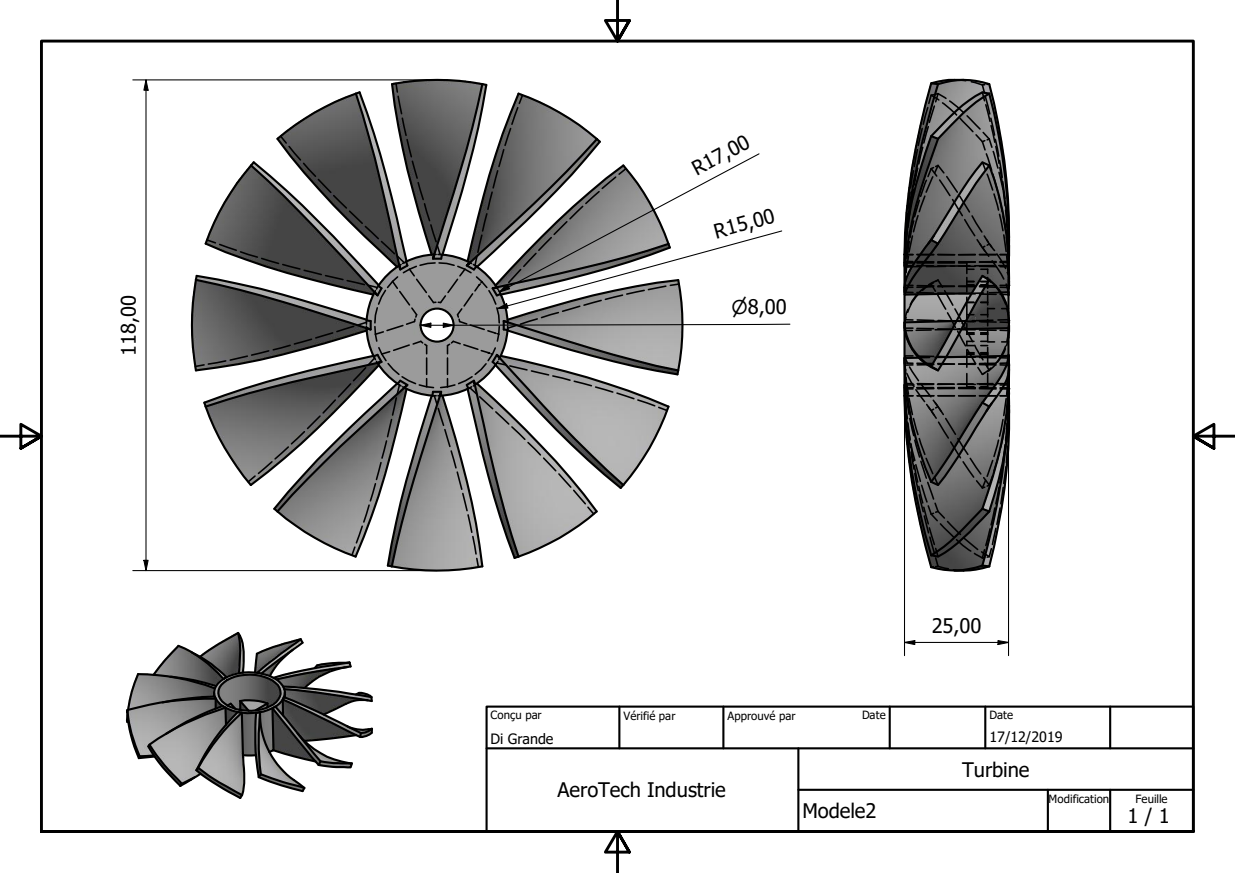
[picture p75: page 1]

Conou par Di Grande | Vprifip par | Approuvp par Date | Date 17/12/2019

AeroTech Industrie | Turbine

Modele2 | Modification | Feuille 1 / 1
